swallow-project/swallow-board-io-sdram/kicad/footprints/swallow-complex-0.6.bmp

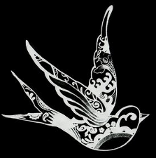
kicad/footprints/swallow-complex-0.6.bmp
