swallow-project/swallow-board-io-sdram/bom/Swallow_IO_SDRAM-bom.xls

ref | value | footprint |  | farnell code | digikey code | Link | Price (10 boards)
C1 | 0805470nF 16V 10% X7R | SM0805
C2 | 0805470nF 16V 10% X7R | SM0805
C3 | 0603100nF 25V 10% X7R | SM0603
C4 | 120610uF 16V 10% X5R | SM1206
C5 | 0603100nF 25V 10% X7R | SM0603
C6 | 120610uF 16V 10% X5R | SM1206
D1 | DUAL_LED-RG-OLS-136UR_SYG | LED_BiColour-1206 |  | 1890325RL |  | http://uk.farnell.com/osa-opto-light/ols-136hr-hyg-xd-t/led-red-green-smd/dp/1890325RL | 0.64
D2 | DUAL_LED-RG-OLS-136UR_SYG | LED_BiColour-1206 |  | 1890325RL |  | http://uk.farnell.com/osa-opto-light/ols-136hr-hyg-xd-t/led-red-green-smd/dp/1890325RL | 0.64
H1 | MOUNTING_HOLE | Hole-3mm
H2 | MOUNTING_HOLE | Hole-3mm
H3 | MOUNTING_HOLE | Hole-3mm
H4 | MOUNTING_HOLE | Hole-3mm
P1 | Cores_T | PIN_ARRAY_2X1 | Samtec 6mm height | 2035892 |  | http://uk.farnell.com/samtec/tsw-102-08-l-s/header-2-54mm-tht-vert-2way/dp/2035892 | 0.29 | SSM10
P2 | VAA In | Power | Harwin | 1022245 |  | http://uk.farnell.com/harwin/m20-9990245/header-tht-2-54mm-1row-2way/dp/1022245 | 0.099 | SSM10
P3 | Vdd_Swallow | PIN_ARRAY_2X1 | Harwin | 1022245 |  | http://uk.farnell.com/harwin/m20-9990245/header-tht-2-54mm-1row-2way/dp/1022245 | 0.099 | SSM10
P4 | Power | PIN_ARRAY_2X1 | Harwin | 1022245 |  | http://uk.farnell.com/harwin/m20-9990245/header-tht-2-54mm-1row-2way/dp/1022245 | 0.099 | SSM10
P5 | Swallow_V2_Core2_I/O | pin_array_8x2 | Harwin | 1022240 |  | http://uk.farnell.com/harwin/m20-9980846/header-2row-8way/dp/1022240 | 0.68 | SSM10
P6 | Cores_MT | PIN_ARRAY_3X1 | Samtec 6mm height | 2035894 |  | http://uk.farnell.com/samtec/htsw-103-13-l-s/header-2-54mm-vertical-tht-3way/dp/1926013 | 0.43 | SSM10
P7 | Cores_MB | PIN_ARRAY_2X1 | Samtec 6mm height | 2035892 |  | http://uk.farnell.com/samtec/tsw-102-08-l-s/header-2-54mm-tht-vert-2way/dp/2035892 | 0.29 | SSM10
P8 | Cores_B | PIN_ARRAY_3X1 | Samtec 6mm height | 2035894 |  | http://uk.farnell.com/samtec/htsw-103-13-l-s/header-2-54mm-vertical-tht-3way/dp/1926013 | 0.43 | SSM10
P9 | VIO | PIN_ARRAY_3X1 | Samtec 6mm height | 2035894 |  | http://uk.farnell.com/samtec/htsw-103-13-l-s/header-2-54mm-vertical-tht-3way/dp/1926013 | 0.43 | SSM10
P10 | SDRAM_Disable | PIN_ARRAY_2X1 | Harwin | 1022245 |  | http://uk.farnell.com/harwin/m20-9990245/header-tht-2-54mm-1row-2way/dp/1022245 | 0.099 | SSM10
P11 | CONN_1 | PIN_ARRAY_1
P12 | Power2 | PIN_ARRAY_2X1 | Harwin | 1022245 |  | http://uk.farnell.com/harwin/m20-9990245/header-tht-2-54mm-1row-2way/dp/1022245 | 0.099 | SSM10
P13 | VAA_Link | PIN_ARRAY_2X1 | Harwin | 1022245 |  | http://uk.farnell.com/harwin/m20-9990245/header-tht-2-54mm-1row-2way/dp/1022245 | 0.099 | SSM10
P14 | Swallow_RST_N_G | PIN_ARRAY_3X1
P15 | +5V_In | PIN_ARRAY_1
P16 | ADC_DOUTB_Bypass | PIN_ARRAY_2X1
P17 | ADC_DOUTA_Bypass | PIN_ARRAY_2X1
R1 | 0R39 | SM0805 |  | 1717794RL |  | http://uk.farnell.com/panasonic/erj6rqfr39v/resistor-0805-0-125w-1-0r39/dp/1717794RL | 0.06 | SSM5
R2 | 08050R | SM0805
U1 | MAX4378 | TSSOP14 |  |  | MAX4378TAUD+-ND | http://www.digikey.com/product-detail/en/MAX4378TAUD%2B/MAX4378TAUD%2B-ND/1701928 | 3.25 | USD
U2 | MAX4378 | TSSOP14 |  |  | MAX4378TAUD+-ND | http://www.digikey.com/product-detail/en/MAX4378TAUD%2B/MAX4378TAUD%2B-ND/1701928 | 3.25 | USD
U3 | 74LS574 | SO20L |  | 1085345 |  | http://uk.farnell.com/nxp/74hc574d/ic-74hc-cmos-smd-74hc574-soic20/dp/1085345 | 0.32
U4 | AD7266 | TQFP32 |  | 1078344 |  | http://uk.farnell.com/analog-devices/ad7266bsuz/ic-12bit-adc-sar-2msps-smd-7266/dp/1078344 | 7.06
 | 74LVC1G00 | SOT353 |  | 1845222RL |  | http://uk.farnell.com/diodes-inc/74lvc1g00se-7/logic-pos-nand-single-2ip-sot353/dp/1845222RL | 0.072
U6 | 74LS574 | SO20L |  | 1085345 |  | http://uk.farnell.com/nxp/74hc574d/ic-74hc-cmos-smd-74hc574-soic20/dp/1085345 | 1
U7 | 2k2 | YC124-JR |  | 9235388 |  | http://uk.farnell.com/yageo-phycomp/yc124-jr-072k2l/resistor-array-arv341-0804-2k2/dp/9235388 | 0.037 | SSM10
U8 | 10k | Bournes CAY-1206 |  | 1770143RL |  | http://uk.farnell.com/bourns/cay16-1002f4lf/resistor-array-1206-10k/dp/1770143RL | 0.042 | SSM50
U9 | 74LVC1G02 | SOT353 |  | 1845220 |  | http://uk.farnell.com/diodes-inc/74lvc1g02se-7/logic-pos-nor-single-2-ip-sot353/dp/1845220 | 0.053
U10 | DRAM-8MX8X4 | TSSOP-54 |  |  | 557-1194-1-ND | http://www.digikey.com/product-detail/en/MT48LC32M8A2P-7E:D%20TR/557-1194-1-ND/965094 | 7.388 | USD
U11 | 10k | Bournes CAY-1206 |  | 1770143RL |  | http://uk.farnell.com/bourns/cay16-1002f4lf/resistor-array-1206-10k/dp/1770143RL | 0.042 | SSM50
U12 | SN74CBTD3306 | SO8E |  | 1750321 |  | http://uk.farnell.com/texas-instruments/sn74cbtd3306cd/logic-switch-bus-fet-dual-8soic/dp/1750321 | 0.22
 | Socket, low profile | 1x2 way | Samtec 13mm height | 1927043 (http://uk.farnell.com/samtec/esq-102-14-l-s/socket-2-54mm-vertical-tht-2way/dp/1927043) |  | http://uk.farnell.com/samtec/esq-102-14-l-s/socket-2-54mm-vertical-tht-2way/dp/1927043 | 1.03 | SSM10
 |  | 1x3 | Samtec | 1927626 |  |  | 1.29 | SSM10
 |  | 1x1 socket 13mm high |  | 1935908
 |  | 2x8 |  | 952-1862-ND |  | http://www.digikey.com/product-detail/en/M20-7821646/952-1862-ND/3727829 | 1.566 | USD SSM1
 |  | m3x14mm spacers | M3X14-VZK |  |  | http://uk.farnell.com/ettinger/05-13-141/spacer-m3x14-vzk/dp/1466855?Ntt=SPACER%2C+M3X14-VZK | 0.25 | 24 or more
 |  | m3x5mm spacers
 |  |  |  |  | Parts total |  | £27.22
 |  | Quantity | 12 |  | Board fab |  | 86
 |  |  |  |  | Board Assy |  | 165
 |  |  |  |  | Sub total |  | £577.62
 |  |  |  |  | Inc VAT Total |  | £693.14
 |  | James' board: |  |  | Parts total |  | 3.11 | USD
 |  |  |  |  | Board Fab |  | 66.15
 |  |  |  |  | Board Assy |  | 51.12
 |  |  |  |  | Sub total |  | £148.37
 |  | Freescale board |  |  |  |  | USD300
 |  |  |  |  |  | GBP | 200
 |  |  |  |  | ALL BOARDS TOTAL |  | £1041.51
 | ****** FOR JAMES' BOARD **********
 | MAX4378 | TSSOP14 | 10 off |  | MAX4378TAUD+-ND | http://www.digikey.com/product-detail/en/MAX4378TAUD%2B/MAX4378TAUD%2B-ND/1701928 | 3.25
 | Caps
SM0805 | 2R | M4 | 15 off |  | 1892946 |  | 0.144 | SSM5
SM0805 | 0.2R | A8 | 20 off |  | 1506143 | http://uk.farnell.com/welwyn/lrcs0805-0r2ft5/resistor-0r2-1-0805/dp/1506143 | 0.061 | SSM10
SM0805 | 0.1R | L1 | 20 off |  | 1506142 | http://uk.farnell.com/bourns/crl0805-fw-r100elf/resistor-0805-r1-1-0-125w/dp/2008297RL | 0.092 | SSM10
Through hole | 2R |  | 50 off |  | 9466916 |  | 0.046
Through hole | 0.2R |  | 10 off |  | 1108093 |  | 0.85
Through hole | 0.1R |  | 10 off |  | 1653230 |  | 0.71
 | Sockets | 10x2 | 20 off |  | 2308554 |  | 1.8 | SSM5
 |  |  |  | spacer 5mm | 1466855 | http://uk.farnell.com/ettinger/05-13-051/spacer-m3x-5-vzk/dp/1466725
 |  |  |  | Spacer 14mm | 1466725 | http://uk.farnell.com/ettinger/05-13-141/spacer-m3x14-vzk/dp/1466855
