swallow-project/swallow-board-io-sdram/manufacturing/bom/Swallow_IO_SDRAM-bom.xls

Swallow_IO_SDRAM Bill of materials
Contact Simon Hollis simon@cs.bris.ac.uk with any queries
Key:
Supplied by PCB Train
Supplied by customer
Not fitted
Mechanical --- ignore for assembly purposes
ref | value | footprint |  | farnell code | digikey code | Link | Price (12 boards)
C1 | 0805470nF 16V 10% X7R | SM0805
C2 | 0805470nF 16V 10% X7R | SM0805
C3 | 0603100nF 25V 10% X7R | SM0603
C4 | 120610uF 16V 10% X5R | SM1206
C5 | 0603100nF 25V 10% X7R | SM0603
C6 | 120610uF 16V 10% X5R | SM1206
D1 | DUAL_LED-RG-OLS-136UR_SYG | LED_BiColour-1206 |  | 1890325RL |  | http://uk.farnell.com/osa-opto-light/ols-136hr-hyg-xd-t/led-red-green-smd/dp/1890325RL | 0.64
D2 | DUAL_LED-RG-OLS-136UR_SYG | LED_BiColour-1206 |  | 1890325RL |  | http://uk.farnell.com/osa-opto-light/ols-136hr-hyg-xd-t/led-red-green-smd/dp/1890325RL | 0.64
H1 | MOUNTING_HOLE | Hole-3mm
H2 | MOUNTING_HOLE | Hole-3mm
H3 | MOUNTING_HOLE | Hole-3mm
H4 | MOUNTING_HOLE | Hole-3mm
P1 | Cores_T | PIN_ARRAY_2X1 | Samtec 6mm height | 2035892 |  | http://uk.farnell.com/samtec/tsw-102-08-l-s/header-2-54mm-tht-vert-2way/dp/2035892 | 0.29
P2 | VAA In | PIN_ARRAY_2X1 | Harwin | 1022245 |  | http://uk.farnell.com/harwin/m20-9990245/header-tht-2-54mm-1row-2way/dp/1022245 | 0.099
P3 | Vdd_Swallow | PIN_ARRAY_2X1 | Harwin | 1022245 |  | http://uk.farnell.com/harwin/m20-9990245/header-tht-2-54mm-1row-2way/dp/1022245 | 0.099
P4 | Power | PIN_ARRAY_2X1 | Harwin | 1022245 |  | http://uk.farnell.com/harwin/m20-9990245/header-tht-2-54mm-1row-2way/dp/1022245 | 0.099
P5 | Swallow_V2_Core2_I/O | pin_array_8x2 | Harwin | 1022240 |  | http://uk.farnell.com/harwin/m20-9980846/header-2row-8way/dp/1022240 | 0.68
P6 | Cores_MT | PIN_ARRAY_3X1 | Samtec 6mm height | 2035894 |  | http://uk.farnell.com/samtec/htsw-103-13-l-s/header-2-54mm-vertical-tht-3way/dp/1926013 | 0.43
P7 | Cores_MB | PIN_ARRAY_2X1 | Samtec 6mm height | 2035892 |  | http://uk.farnell.com/samtec/tsw-102-08-l-s/header-2-54mm-tht-vert-2way/dp/2035892 | 0.29
P8 | Cores_B | PIN_ARRAY_3X1 | Samtec 6mm height | 2035894 |  | http://uk.farnell.com/samtec/htsw-103-13-l-s/header-2-54mm-vertical-tht-3way/dp/1926013 | 0.43
P9 | VIO | PIN_ARRAY_3X1 | Samtec 6mm height | 2035894 |  | http://uk.farnell.com/samtec/htsw-103-13-l-s/header-2-54mm-vertical-tht-3way/dp/1926013 | 0.43
P10 | SDRAM_Disable | PIN_ARRAY_2X1 | Harwin | 1022245 |  | http://uk.farnell.com/harwin/m20-9990245/header-tht-2-54mm-1row-2way/dp/1022245 | 0.099
P11 | CONN_1 | PIN_ARRAY_1
P12 | Power2 | PIN_ARRAY_2X1
P13 | VAA_Link | PIN_ARRAY_2X1
P14 | Swallow_RST_N_G | PIN_ARRAY_3X1
P15 | +5V_In | PIN_ARRAY_1
P16 | ADC_DOUTB_Bypass | PIN_ARRAY_2X1
P17 | ADC_DOUTA_Bypass | PIN_ARRAY_2X1
R1 | 0R39 | SM0805 |  | 1717794RL |  | http://uk.farnell.com/panasonic/erj6rqfr39v/resistor-0805-0-125w-1-0r39/dp/1717794RL | 0.06
R2 | 08050R | SM0805
U1 | MAX4378 | TSSOP14 |  |  | MAX4378TAUD+-ND | http://www.digikey.com/product-detail/en/MAX4378TAUD%2B/MAX4378TAUD%2B-ND/1701928 | 3.25
U2 | MAX4378 | TSSOP14 |  |  | MAX4378TAUD+-ND | http://www.digikey.com/product-detail/en/MAX4378TAUD%2B/MAX4378TAUD%2B-ND/1701928 | 3.25
U3 | 74LS574 | SO20L |  | 1085345 |  | http://uk.farnell.com/nxp/74hc574d/ic-74hc-cmos-smd-74hc574-soic20/dp/1085345 | 0.32
U4 | AD7266 | TQFP32 |  | 1078344 |  | http://uk.farnell.com/analog-devices/ad7266bsuz/ic-12bit-adc-sar-2msps-smd-7266/dp/1078344 | 7.06
U5 | 74LVC1G00 | SOT353 |  | 1845222RL |  | http://uk.farnell.com/diodes-inc/74lvc1g00se-7/logic-pos-nand-single-2ip-sot353/dp/1845222RL | 0.072
U6 | 74LS574 | SO20L |  | 1085345 |  | http://uk.farnell.com/nxp/74hc574d/ic-74hc-cmos-smd-74hc574-soic20/dp/1085345 | 1
U7 | 2k2 | YC124-JR |  | 9235388 |  | http://uk.farnell.com/yageo-phycomp/yc124-jr-072k2l/resistor-array-arv341-0804-2k2/dp/9235388 | 0.037
U8 | 10k | Bournes CAY-1206 |  | 1770143RL |  | http://uk.farnell.com/bourns/cay16-1002f4lf/resistor-array-1206-10k/dp/1770143RL | 0.042
U9 | 74LVC1G02 | SOT353 |  | 1845220 |  | http://uk.farnell.com/diodes-inc/74lvc1g02se-7/logic-pos-nor-single-2-ip-sot353/dp/1845220 | 0.053
U10 | DRAM-8MX8X4 | TSSOP-54 |  |  | 557-1194-1-ND | http://www.digikey.com/product-detail/en/MT48LC32M8A2P-7E:D%20TR/557-1194-1-ND/965094 | 7.388
U11 | 10k | Bournes CAY-1206 |  | 1770143RL |  | http://uk.farnell.com/bourns/cay16-1002f4lf/resistor-array-1206-10k/dp/1770143RL | 0.042
U12 | SN74CBTD3306 | SO8E |  | 1750321 |  | http://uk.farnell.com/texas-instruments/sn74cbtd3306cd/logic-switch-bus-fet-dual-8soic/dp/1750321 | 0.22
Total assembled components |  | 25
Total unique components |  | 17
Total BGAs |  | 0
