swallow-project/swallow-board-io-sdram/bom/digikey-questionnaire-completed.docx

The following information is required by Digi-Key, so that we may comply with US Export Laws. All the information provided is confidential and requested of all International and Domestic customers prior to export. Providing complete and accurate information will help your order to ship promptly.

- What does your company do? (not required if your order is for individual / personal use

University education.

- For what type of application are these parts intended?

A research project.

- Please describe the specific application for which these parts will be used.

To produce an power monitor for testing an embedded platform as part of a research project.

- What is the country of ultimate destination?

UK

- Who is the end user for these parts? (Please supply company name or target consumer group)

University of Bristol, UK
