swallow-project/swallow-board-io-sdram/manufacturing/schematic/Swallow_IO_SDRAM.pdf

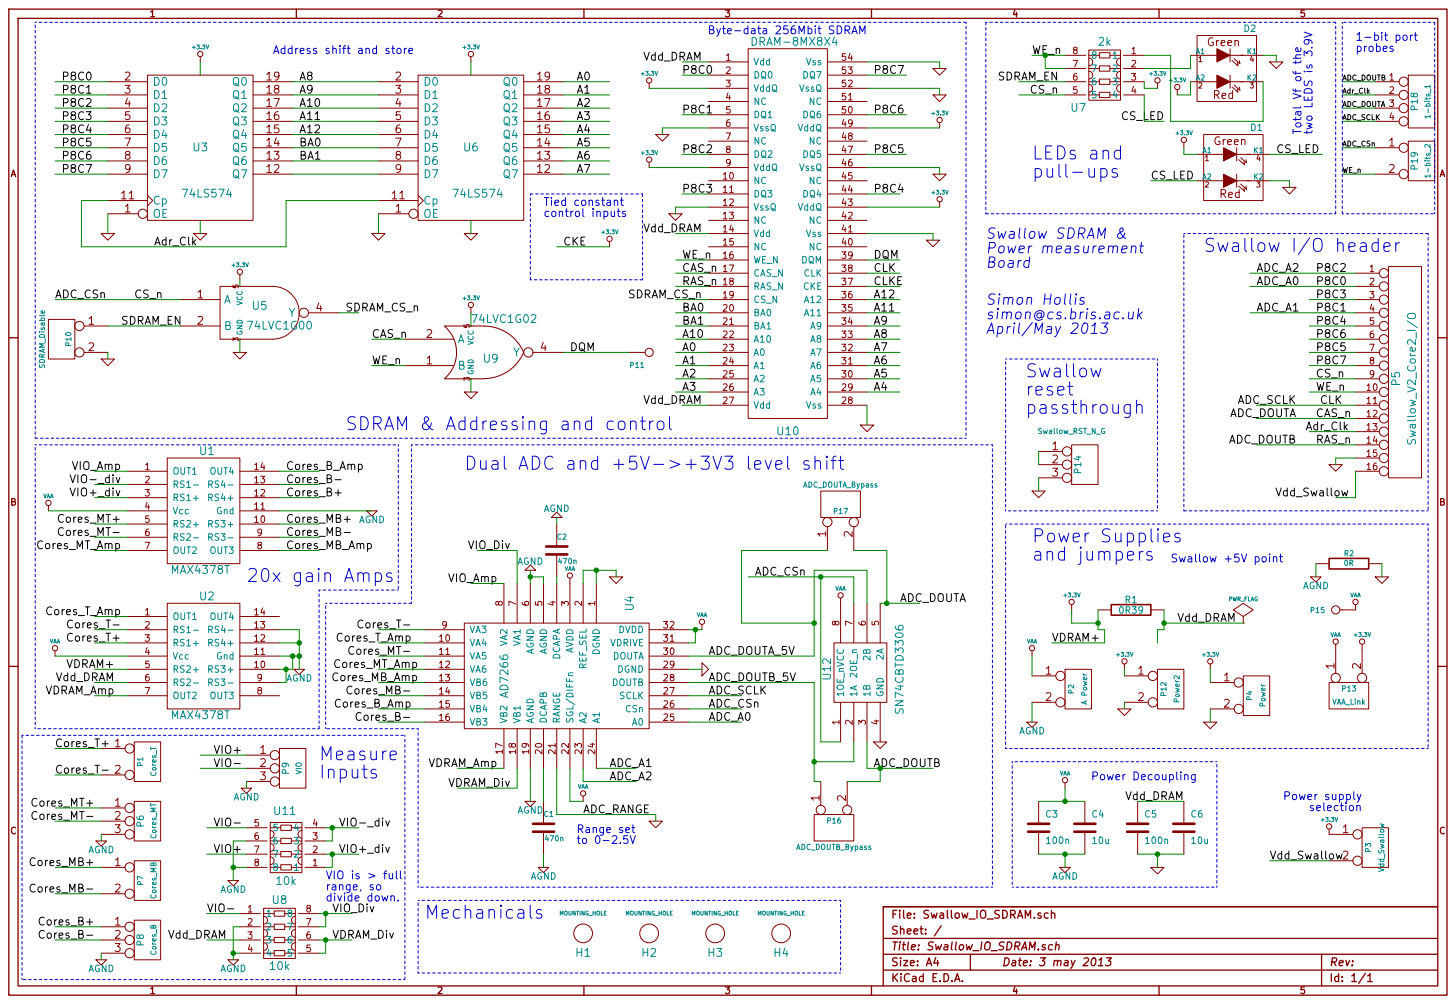
[picture p2: page 1]

Green Red | 3K1

Address shift and store Adr_Clk

6 3 5 | 3 +3.3V SDRAM_EN

+3.3V Tied constant control inputs

simon@cs.bris.ac.uk
April/May 2013

P16 ADC_DOUTB_Bypass SDRAM & Addressing and control

Dual ADC and +5V->+3V3 level shift

8 VA3 9 VA4 10 DCAPB 20 DOUTA 30 VA5 11 RANGE 21 VDRIVE 31 VA6 12 SGL/DIFFn 22 DVDD 32 VB6 13 A2 23 VB5 14 A1 24 VB4 15 A0 25 VB3 16 CSn 26 VB2 17 SCLK 27 VB1 18 DOUTB 28 AGND 19 DGND 29 U4 AD7266

7 | 7 2 | 2
8 1 | 1
