swallow-project/swallow-board-io-sdram/(commit log)

2013-04-03 SDRAM expansion for the Swallow V2 Core_2_IO header.
    [Swallow_IO_SDRAM.sch]
2013-04-04 Changed control from a latch to direct connection to 1-bit ports to allow DRAM protocol to be implemented more easily. Effect of moving I2C to additional header for Swallow W1 link or another connect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
    [Swallow_IO_SDRAM.sch]
2013-04-04 Provisional looking-good layout.
    [Swallow_IO_SDRAM.sch]
2013-04-05 Updated board layout for SOIC-20 package. Nearly finished layout of power.
    [Swallow_IO_SDRAM.kicad_pcb]
2013-04-05 Layout of tracks completed and DRC'd. Silkscreen to go.
    [Swallow_IO_SDRAM.kicad_pcb, Swallow_IO_SDRAM.sch]
2013-04-05 Completed silkscreen, with exception of UoB and u logos.
    [Swallow_IO_SDRAM.kicad_pcb]
2013-04-06 Ported design to use correct latch part: 74574. Updated layout accordingly.
    [Swallow_IO_SDRAM.kicad_pcb, Swallow_IO_SDRAM.sch]
2013-04-06 Flipped FFC header to back side so that wire does not need to twist.
    [Swallow_IO_SDRAM.kicad_pcb, Swallow_IO_SDRAM.sch]
2013-04-26 Added power measurement via AD7266 ADC and MAX4378 Amps to design. Need to solve the chip select problem and sharing of signal pins.
    [Swallow_IO_SDRAM.sch]
2013-04-27 Completed schematic for power measurement addition.
    [Swallow_IO_SDRAM.sch]
2013-04-27 Associated new footprints for power measurement.
2013-04-27 Fixed one footprint.
2013-04-27 Added mounting hole.
    [Swallow_IO_SDRAM.sch]
2013-04-27 Back-annotated footprints to schematic.
    [Swallow_IO_SDRAM.sch]
2013-04-27 Re-configured footprints.
    [Swallow_IO_SDRAM.sch]
2013-04-27 Begin layout of updated design.
    [Swallow_IO_SDRAM.kicad_pcb, Swallow_IO_SDRAM.sch]
2013-04-27 Good progress in layout. New boundary of 45x35 proposed.
    [Swallow_IO_SDRAM.kicad_pcb]
2013-04-28 Updated board profile to L shape with max dim 45x55mm.
    [Swallow_IO_SDRAM.kicad_pcb]
2013-04-28 Placed all current sense headers on top of equivalent Swallow positions.
    [Swallow_IO_SDRAM.kicad_pcb, Swallow_IO_SDRAM.sch]
2013-04-28 Updated one placement.
    [Swallow_IO_SDRAM.kicad_pcb]
2013-04-28 Placed second drill hole.
    [Swallow_IO_SDRAM.kicad_pcb, Swallow_IO_SDRAM.sch]
2013-04-28 Some sketch new PCB outlines.
    [Swallow_IO_SDRAM.kicad_pcb]
2013-04-28 Edges now corrected.
    [Swallow_IO_SDRAM.kicad_pcb]
2013-04-28 Use of auto-router and only two lines unconnected.
    [Swallow_IO_SDRAM.kicad_pcb, Swallow_IO_SDRAM.sch]
2013-04-28 This is a Freeroute routable design with lots of freedom left.
    [Swallow_IO_SDRAM.kicad_pcb]
2013-04-29 Updated with some safety features and AGND<->GND link. Routing ready.
    [Swallow_IO_SDRAM.kicad_pcb, Swallow_IO_SDRAM.sch]
2013-04-29 Increased the thickness of the power supply traces before routing.
    [Swallow_IO_SDRAM.kicad_pcb]
2013-04-29 Updated LEDs and thickened power wires.
    [Swallow_IO_SDRAM.kicad_pcb, Swallow_IO_SDRAM.sch]
2013-04-29 More power plane freedom.
    [Swallow_IO_SDRAM.kicad_pcb]
2013-04-29 Routed design.
    [Swallow_IO_SDRAM.kicad_pcb]
2013-04-29 Updated board to have correct offsets for Swallow headers.
    [Swallow_IO_SDRAM.kicad_pcb, Swallow_IO_SDRAM.sch]
2013-04-29 Solved DRC problems caused by clearances at IC pins.
    [Swallow_IO_SDRAM.kicad_pcb]
2013-04-29 Added RST_N_G Header through from Swallow board.
    [Swallow_IO_SDRAM.kicad_pcb, Swallow_IO_SDRAM.sch]
2013-04-29 Fixed newly-moved header traces.
    [Swallow_IO_SDRAM.kicad_pcb]
2013-04-29 Fixed edges.
    [Swallow_IO_SDRAM.kicad_pcb]
2013-04-29 Swapped a resistor connection to simplify routing.
    [Swallow_IO_SDRAM.kicad_pcb, Swallow_IO_SDRAM.sch]
2013-04-30 Successfully performed routing. Added BOM with most parts filled in. Need to resize the divider Rs to a 1206 package.
    [Swallow_IO_SDRAM-bom.xls, Swallow_IO_SDRAM.csv, Swallow_IO_SDRAM.kicad_pcb, Swallow_IO_SDRAM.sch]
2013-04-30 Changed U8 to 1206 footprint.
    [Swallow_IO_SDRAM.kicad_pcb]
2013-04-30 Auto-routed the design.
    [Swallow_IO_SDRAM.kicad_pcb]
2013-04-30 Improved ground plane a bit. Only tweaking now to go :)
    [Swallow_IO_SDRAM.kicad_pcb]
2013-04-30 Fixed references on silkscreen.
    [Swallow_IO_SDRAM.kicad_pcb]
2013-04-30 Added logos and descripton to silkscreen.
2013-04-30 Smoothed out some overly-circuitous auto-routed traces.
2013-04-30 Added ground and power planes and reduced return current lengths.
2013-04-30 Moved a trace away from the top mounting hole.
2013-04-30 Completed BOM.
    [Swallow_IO_SDRAM-bom.xls]
2013-04-30 Completed full BOM.
    [Swallow_IO_SDRAM-bom.xls]
2013-05-01 Added +5V VAA input and changed MB header to 2 pins from erroneous 3 pins.
    [Swallow_IO_SDRAM.sch]
2013-05-01 Added in a voltage divider onto the VIO signal to prevent it from going out of range. Added to layout.
    [Swallow_IO_SDRAM.sch]
2013-05-01 Added in level shifter to library and schematic.
    [Swallow_IO_SDRAM.sch]
2013-05-01 Added level shifting and level shifting bypass for DOUTA,B.
    [Swallow_IO_SDRAM.sch]
2013-05-01 Mounting holes resized for M3 screws.
2013-05-01 Moved VIO header and improved ground and VDD loops in analogue section.
2013-05-01 Added two more 3mm only holes in corners in case of need for more mechanical stability.
2013-05-01 Improved silkscreen. Added author's name :)
2013-05-01 Add schematic.
    [Swallow_IO_SDRAM.sch]
2013-05-02 Corrected some typos and U7 value on schematic.
    [Swallow_IO_SDRAM.sch]
2013-05-02 Re-formatted schematic to group components and massively improve readability.
    [Swallow_IO_SDRAM.sch]
2013-05-02 Added last two mounting holes manually. Just back silkscreen to finish. :)
    [Swallow_IO_SDRAM.sch]
2013-05-02 Moved U11 to better location. Re-routed VIO- to avoid making a slot in the ground plane :)
2013-05-02 Improved GNDA loop.
2013-05-02 Moved SN74CBTD3306C footprint to SO-8E.
    [Swallow_IO_SDRAM-bom.xls, Swallow_IO_SDRAM.csv, Swallow_IO_SDRAM.sch]
2013-05-02 Changed R1 to 0R39 following detailed current calculation.
    [Swallow_IO_SDRAM.sch]
2013-05-02 Updated BOM for order.
    [Swallow_IO_SDRAM-bom.xls]
2013-05-03 Added extra 1-bit port headers.
    [Swallow_IO_SDRAM.sch]
2013-05-03 Added rear silkscreen texts.
2013-05-03 Added layer labels for gerber. Oversized mask.
2013-05-03 Added manufacturing data as sent to PCBTrain.
    [Swallow_IO_SDRAM-B_Cu.gbl, Swallow_IO_SDRAM-B_Mask.gbs, Swallow_IO_SDRAM-B_Paste.gbp, Swallow_IO_SDRAM-B_SilkS.gbo, Swallow_IO_SDRAM-Cmts_User.gbr, Swallow_IO_SDRAM-Edge_Cuts.gbr, Swallow_IO_SDRAM-F_Cu.gtl, Swallow_IO_SDRAM-F_Mask.gts]
2013-11-20 Altered schematic for V3 boards. Removed many parts and relabelled many connections.
    [Swallow_IO_SDRAM.sch]
